topisani/OTTO-proto-1/images/closed.jpeg

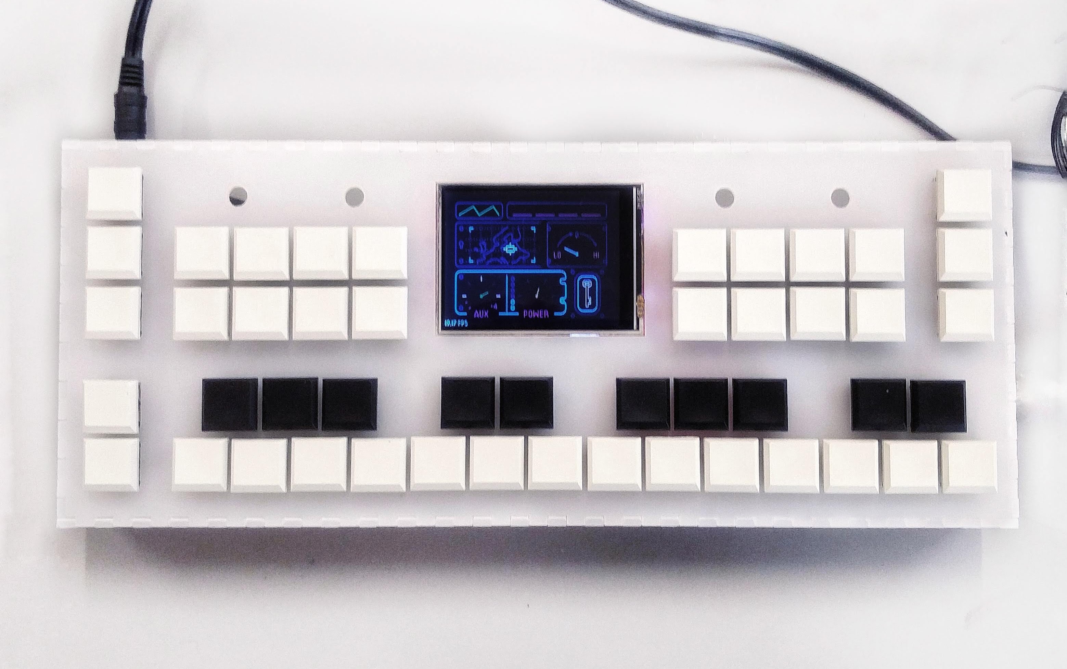
images/closed.jpeg
