topisani/OTTO-proto-1/images/open.jpeg

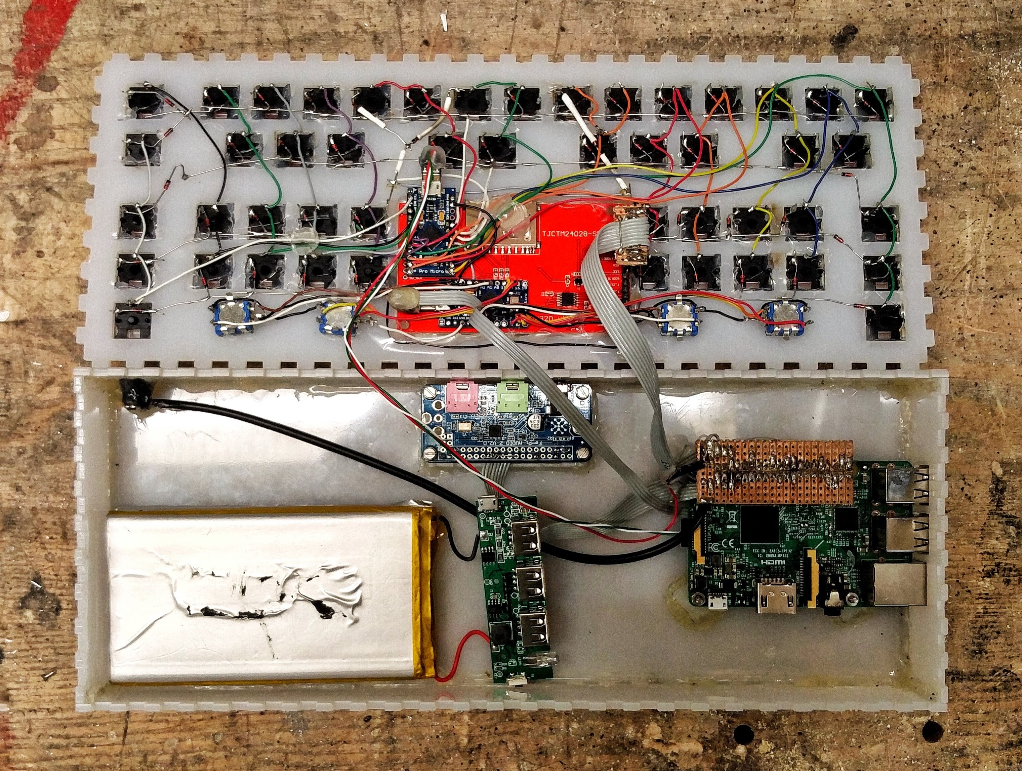
images/open.jpeg
